kris2475/AgriPV/Demonstrator.jpg

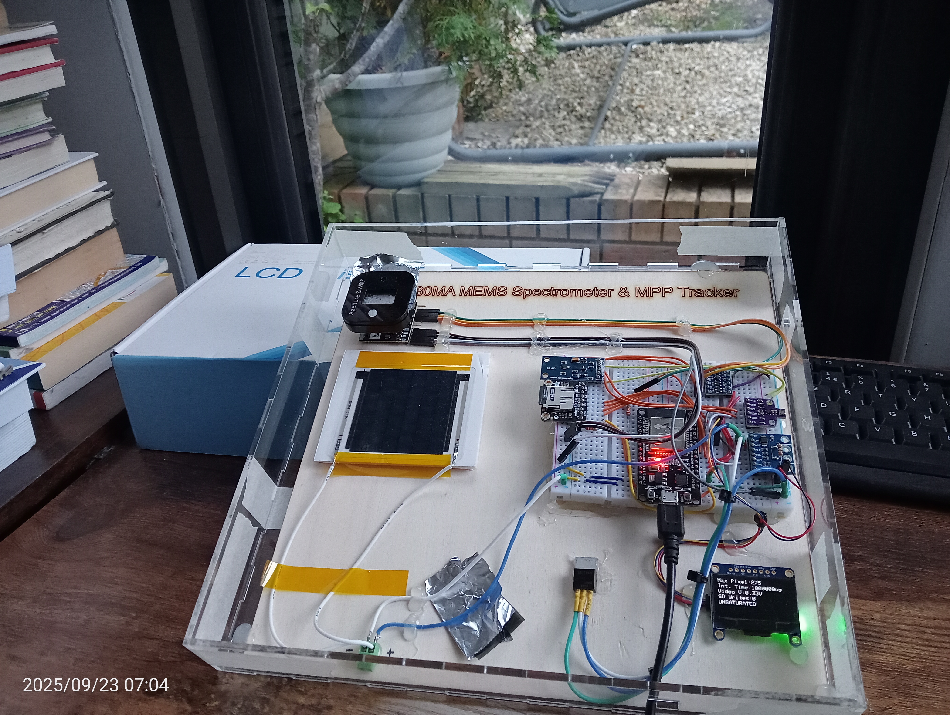
Demonstrator.jpg
