kris2475/AgriPV/Convergence of OPVs and Spectral Intelligence in AgriPV.md

# The Convergence of Organic Photovoltaics and Spectral Intelligence in AgriPV

The future of sustainable agriculture hinges on the synergy between advanced materials and intelligent monitoring, a domain perfectly embodied by **Organic Photovoltaics (OPVs)** integrated into controlled environments like AgriPV and polytunnels.

---

## Why OPVs?

OPVs offer distinct advantages over rigid silicon PVs:

- **Lightweight**
- **Mechanically flexible**
- **Tunable light absorption spectra**

This unique trait allows researchers to design **semi-transparent solar cells** that both:

1. Generate electricity  
2. Optimise the light spectrum transmitted to crops beneath  

This dual role enables simultaneous **energy generation** and **crop yield optimisation**.

---

## The Challenge: Solar Degradation

A significant challenge for OPV deployment is **solar degradation**. Unlike traditional PV, OPVs suffer from complex deterioration pathways caused by:

- Photo-oxidation  
- Thermal stress  
- Moisture ingress  

This leads to a measurable decline in performance over time.  

Effectively combating and modelling this degradation requires **abundant, synchronized, high-fidelity data**—precisely the goal of the **low-cost IoT sensing platform**.

---

## Maximum Power Point Tracking (MPPT)

To ensure every photon is maximised despite fluctuating conditions and degradation:

- **MPPT is essential**.  
- The widely used **Perturb and Observe (P&O)** algorithm operates by making small, iterative changes (perturbations) to the panel’s voltage and observing whether power output increases or decreases.  
- This allows the system to continuously lock onto the **maximum power point**.  

### Low-Light Fix

A key adaptation in the **ESP32-based design** is the **low-light fix**:

- Pauses the P&O routine at night  
- Resets the system at dawn  
- Prevents inefficient operation  
- Protects the OPV module  

---

# Spectral Dynamics and Crop Health in Polytunnels

The light environment within a polytunnel is **highly dynamic**—its manipulation is crucial for maximising **both energy efficiency and crop productivity**.

---

## Light Quality and Polytunnel Albedo

Polytunnel films act as critical **spectral filters**:

- **Standard films** block much UV radiation, sometimes reducing crop nutritional quality (e.g., phenolic compounds) compared to open-field systems.  
- **Photo-selective films** are engineered to enhance or diffuse specific wavelengths (e.g., **red/far-red ratios**) that drive growth.  

**Examples:**

- **Blue light** → vegetative growth  
- **Red light** → flowering and fruiting  
- Crops like **tomatoes, peppers, cucumbers** thrive with high light requirements.  

The **overall albedo** (total reflected incoming light) depends not only on the film, but also on the **crops themselves**.

---

## The Crop-as-Sensor Feedback Loop

The crop canopy acts as a **spectral sensor**:

- Healthy, chlorophyll-rich leaves:  
  - Absorb **red and blue light**  
  - Reflect strongly in **green and NIR** regions  

- Stressed plants (water deficiency, pests, disease):  
  - Reduced chlorophyll → shifts in reflected spectrum  
  - Detectable via albedo measurements  

---

# Data Acquisition and Spectral Intelligence: The OPV-IoT-Spectra Connection

Here is where the integrated sensing platform in AgriPV and polytunnels shows its true innovation:

The **ambient light** is both:

- The **energy source** for the OPV array  
- The **signal** analysed by the **C12880MA MEMS Spectrometer**  

The platform, built around the **ESP32 microcontroller** and **INA226 power sensor**, allows for the simultaneous acquisition of critical data:

- Logging the **electrical performance** of the OPV module under real-world conditions  
- Capturing a **spectral fingerprint** of the ambient light and the crop canopy health  

This high-fidelity data provides the foundation for PV engineers to **tune OPV designs**—optimising their spectral transparency to the specific light requirements of crops within AgriPV and polytunnel environments.

---

## Towards Smart, Self-Sustaining Systems

By continuously logging synchronised **electrical, spectral, and environmental data**, the platform builds training datasets for advanced **ML/DL models**.  

These models enable:

- **Predictive modelling** of OPV aging  
- **Actionable insights** for crop management  

Ultimately transforming polytunnels into **smart, self-sustaining energy and food production units**.
