kris2475/AgriPV/Sample Data/AgriPV_plot.png

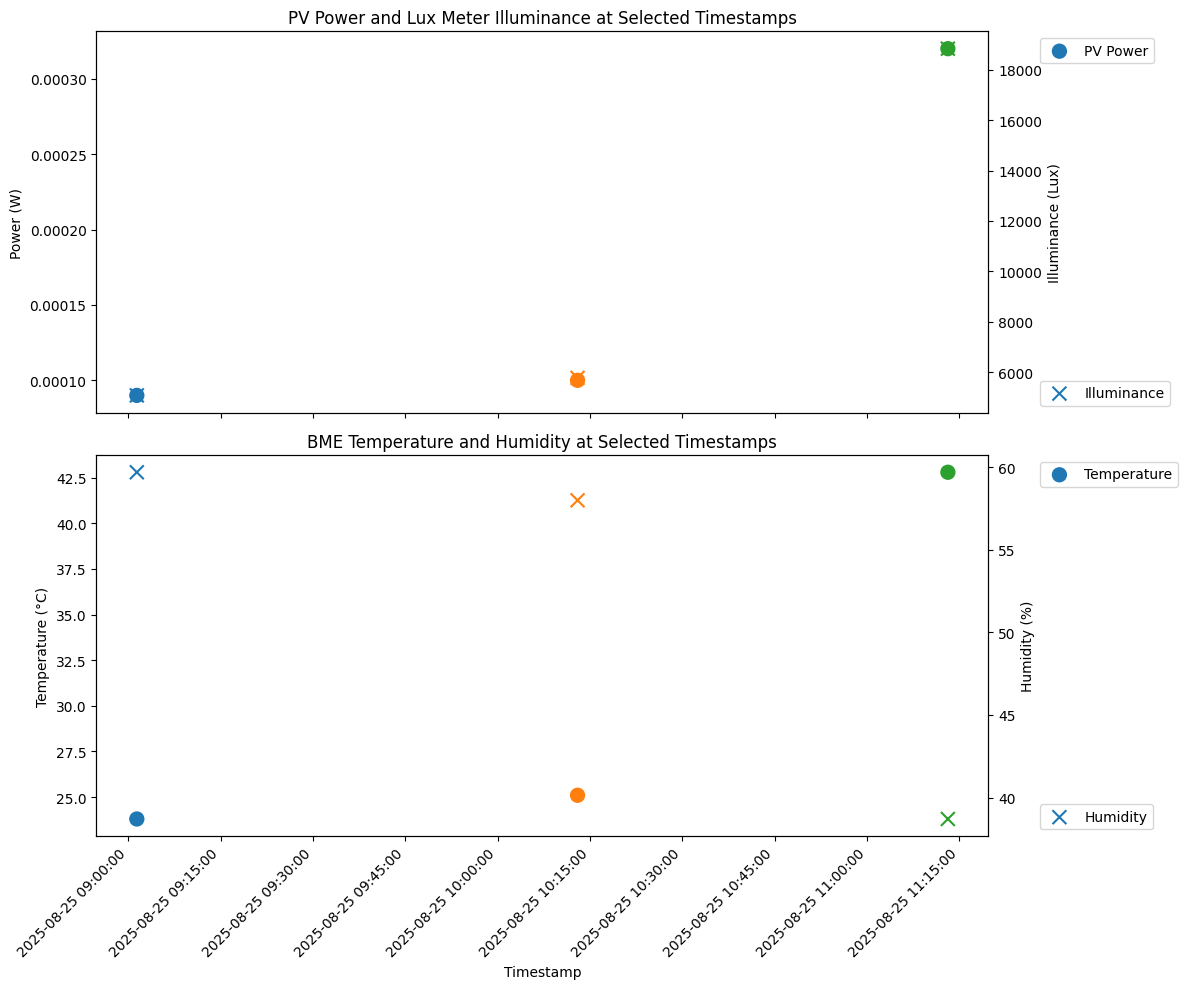
Sample Data/AgriPV_plot.png
