kris2475/AgriPV/Sample Data/AgriPV_spectra.png

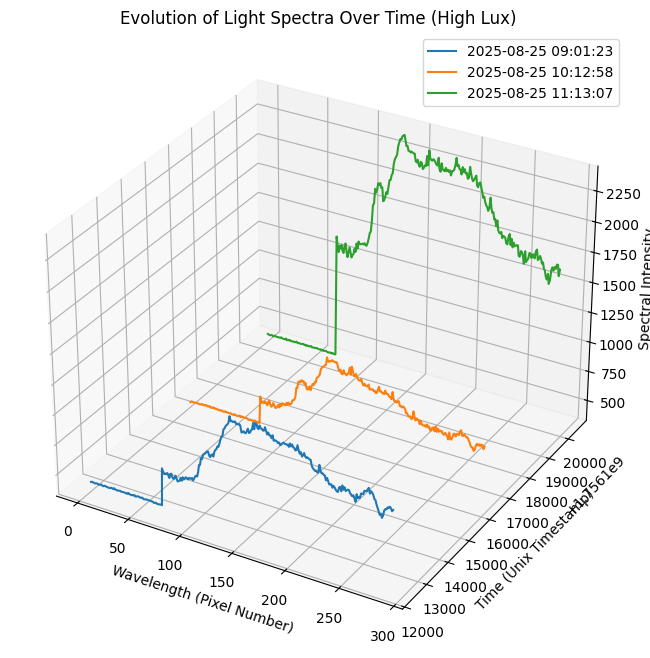
Sample Data/AgriPV_spectra.png
