kris2475/AgriPV/(commit log)

2025-10-03 Rename AgriPV_spectra.png to Sample Data/AgriPV_spectra.png
2025-10-03 Rename AgriPV_plot.png to Sample Data/AgriPV_plot.png
